wonderfullook/simple_logic_analyzer/fpga/src/fifo245.sv

module fifo245 #(

) (
    input wire rst_n,
    output wire debug,
    input wire [7 : 0] capture,
    output wire [7 : 0] data,
    input wire rxf_n,
    input wire txe_n,
    output wire rd_n,
    output reg wr_n,
    input wire clk,
    output wire oe_n,
    output wire siwu_n
);

assign oe_n = 'b1;
assign rd_n = 'b1;
assign siwu_n = 'b1;

localparam COUNTER_SIZE = 3;

reg [COUNTER_SIZE - 1:0] counter = 'b0;

reg [7:0] reg_data = 'b0;

initial begin
    wr_n = 1'b1;
end

assign debug = rst_n;

assign data = reg_data;

always @(posedge clk or negedge rst_n) begin
    if (rst_n == 'b0) begin
        counter <= 'b0;
        wr_n <= 'b1;
        reg_data <= capture;
    end else begin
        if (wr_n == 'b0) begin
            if (txe_n == 'b0) begin
                wr_n <= 'b1;
            end;
        end else begin
            if (counter == 0) begin
                reg_data <= capture;
            end
            if (counter == 1) begin
                wr_n <= 'b0;
            end
        end;
        counter <= counter + 1'b1;
    end
end

endmodule
